foehnsturm/Mark2/Mark 2 expansion board/Expansion board schematic rev1.jpg

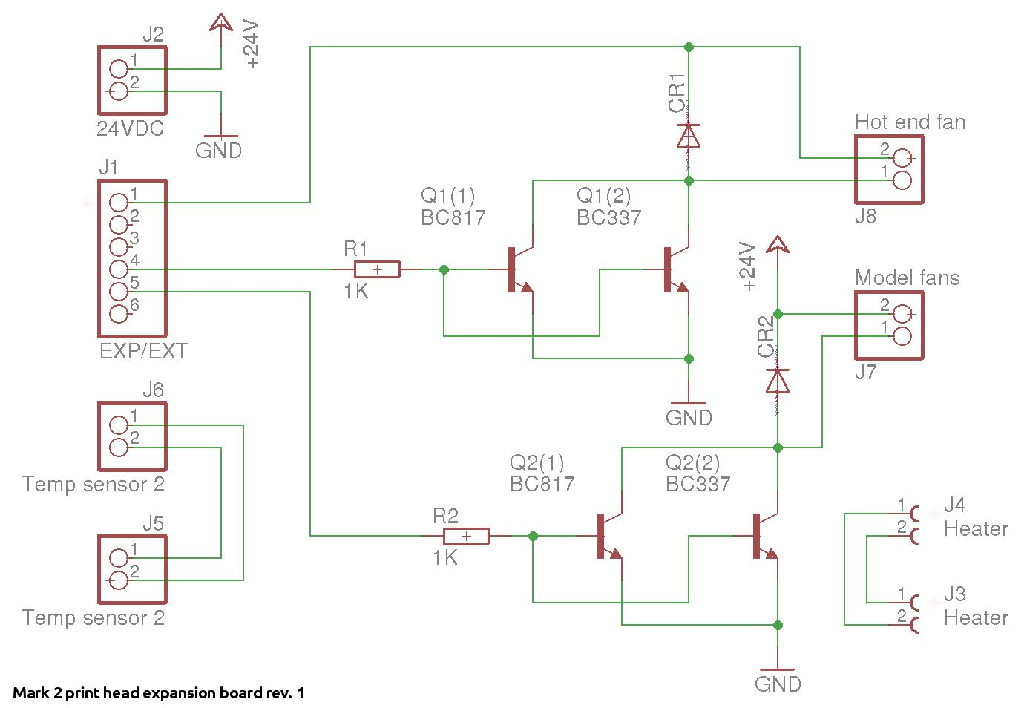
Mark 2 expansion board/Expansion board schematic rev1.jpg
