foehnsturm/Mark2/Mark 2 expansion board/Expansion board BOM rev1.xls

Mark 2 expansion PCB BOM
Designator | Type | Package | Description | RS components | Mouser | Farnell | Digi-key | Elfa | Legend
CR1 | S1G-E3/5AT | DO-214AC | Diode, 400V, 1A | 918-9663 | 625-S1G-E3/5AT | 9550240 | S1G-E3/5ATGICT-ND | 300-31-394 | SMD
CR2 | S1G-E3/5AT | DO-214AC | Diode, 400V, 1A | 918-9663 | 625-S1G-E3/5AT | 9550240 | S1G-E3/5ATGICT-ND | 300-31-394 | Through-hole
CR1 | 1N4004 | DO-41 | Diode, 400V, 1A | 738-4721 | 821-1N4004 | 9565027 | 1N4004DICT-ND | 110-52-625 | Common
CR2 | 1N4004 | DO-41 | Diode, 400V, 1A | 738-4721 | 821-1N4004 | 9565027 | 1N4004DICT-ND | 110-52-625
J1 |  |  | 0.1” 6-way dual row header, right angle | 767-0855 | 571-5-102975-3 | 2356195 | 5-102975-3-ND | 143-00-587
J2 |  |  | 0.1” breakaway header, right angle | 828-1651 | 538-22-28-8360 | 1593439 | WM50013-36-ND | 143-71-403
J3 |  |  | Terminal block, 5mm pitch | 361-7667 | 571-2828362 | 3089034 | A98076-ND | 300-42-827
J4 |  |  | Terminal block, 5mm pitch | 361-7667 | 571-2828362 | 3089034 | A98076-ND | 300-42-827
J5 | 171857-0002 |  | Molex KK-254, 2-way, right angle | 792-2893 | 538-171857-4002 | 2445505 | WM10157-ND | 300-65-089
J6 | 171857-0002 |  | Molex KK-254, 2-way, right angle | 792-2893 | 538-171857-4002 | 2445505 | WM10157-ND | 300-65-089
J7 | 171857-0002 |  | Molex KK-254, 2-way, right angle | 792-2893 | 538-171857-4002 | 2445505 | WM10157-ND | 300-65-089
J8 | S2B-XH-A |  | JST XH, 2-way, right angle | 820-1582 |  | 1516289 | 455-2257-ND | 143-02-006
Q1 | BC817-40 | SOT-23-3 | Transistor, 45V, 500mA | 464-243 | 863-BC817-40LT1G | 2317574 | 1727-2919-1-ND | 300-50-353
Q2 | BC817-40 | SOT-23-3 | Transistor, 45V, 500mA | 464-243 | 863-BC817-40LT1G | 2317574 | 1727-2919-1-ND | 300-50-353
Q1 | BC337-40 | TO-92 | Transistor, 45V, 500mA | 796-9672 | 610-BC337-40 | 9558675 | BC33740TACT-ND | 171-01-459
Q2 | BC337-40 | TO-92 | Transistor, 45V, 500mA | 796-9672 | 610-BC337-40 | 9558675 | BC33740TACT-ND | 171-01-459
R1 |  | 3216 (metric) | Resistor, 1K, 250mW | 808-4182 | 71-CRCW1206-1.0K-E3 | 1469965 | 541-1.00KFCT-ND | 300-56-913
R2 |  | 3216 (metric) | Resistor, 1K, 250mW | 808-4182 | 71-CRCW1206-1.0K-E3 | 1469965 | 541-1.00KFCT-ND | 300-56-913
R1 |  |  | Resistor, 1K, 250mW | 707-7666 | 660-MF1/4DCT52R1001F | 9341102 | CF14JT1K00CT-ND | 160-50-232
R2 |  |  | Resistor, 1K, 250mW | 707-7666 | 660-MF1/4DCT52R1001F | 9341102 | CF14JT1K00CT-ND | 160-50-232
Cable assemblies
Required | Type | Package | Description | RS components | Mouser | Farnell | Digi-key | Elfa
2 ea. | 22-01-2025 |  | Molex KK-254, 2-way crimp housing | 296-4934 | 538-22-01-2025 | 143126 | WM2613-ND | 143-80-465
2 ea. |  |  | 0.1" ribbon cable 6-way housing | 863-3251 | 649-71600-106LF | 2112419 | 609-2842-ND
2 ea. |  |  | 0.1" pitch, 2-way housing | 681-2812 | 855-M20-1060200 | 865606 | 952-2227-ND
4 ea. |  |  | 0.1” header crimp socket | 681-2878 | 855-M20-1160042 | 1022219 | 952-2158-ND
4 ea. | 08-50-0032 |  | Molex KK-254 crimp pin | 467-598 | 538-08-50-0032 | 2424111 | WM2623-ND | 143-80-598
60 cm |  |  | 28 AWG 1.27mm pitch ribbon cable | 815-8003 | 517-3365/06-100 | 2064464 | 3365/06 100-ND
2x30 cm |  |  | 18 AWG wire, PTFE / ETFE insulation
4x40 cm |  |  | 24 AWG wire, various colors
