foehnsturm/Mark2/calibration/mark2_xy_calibration_part_a.stl

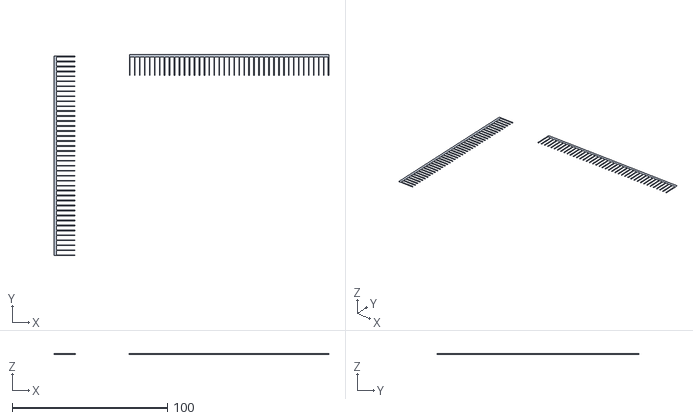
[picture p2: CAD file, 2017-04-28]
calibration/mark2_xy_calibration_part_a.stl
177.1 x 129.6 x 0.3
