foehnsturm/Mark2/part-files/coupling.stp

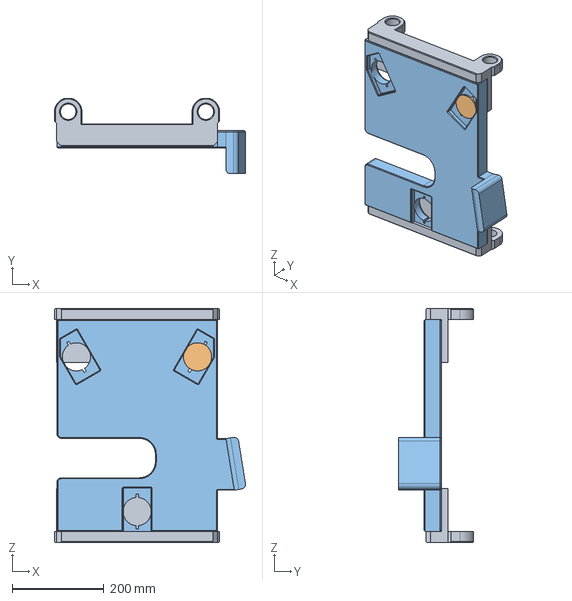
[picture p3: CAD file, 2018-01-26]
part-files/coupling.stp
416.6 x 164.2 x 510.0 mm
