foehnsturm/Mark2/calibration/mark2_xy_calibration_part_b.stl

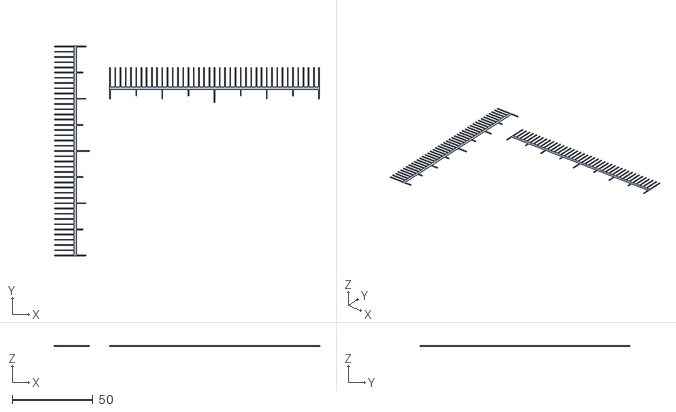
[picture p4: CAD file, 2017-04-28]
calibration/mark2_xy_calibration_part_b.stl
164.3 x 130.1 x 0.3
