foehnsturm/Mark2/part-files/head.stp

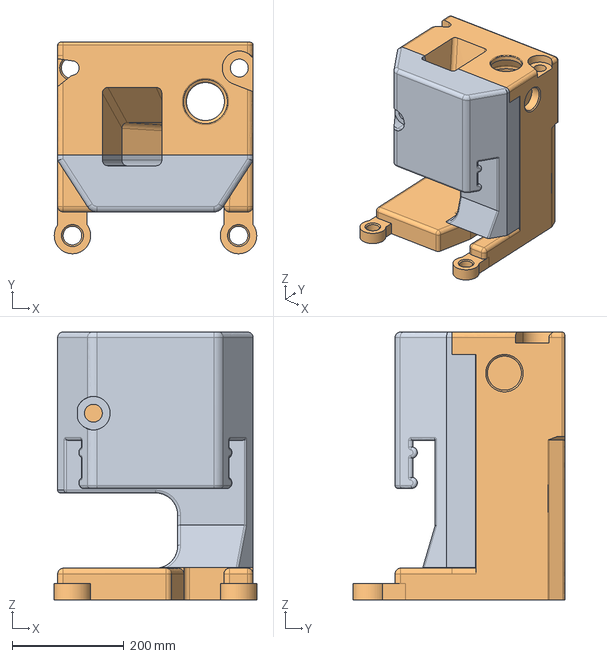
[picture p5: CAD file, 2018-01-26]
part-files/head.stp
362.8 x 378.9 x 480.0 mm
