foehnsturm/Mark2/part-files/head-b.stl

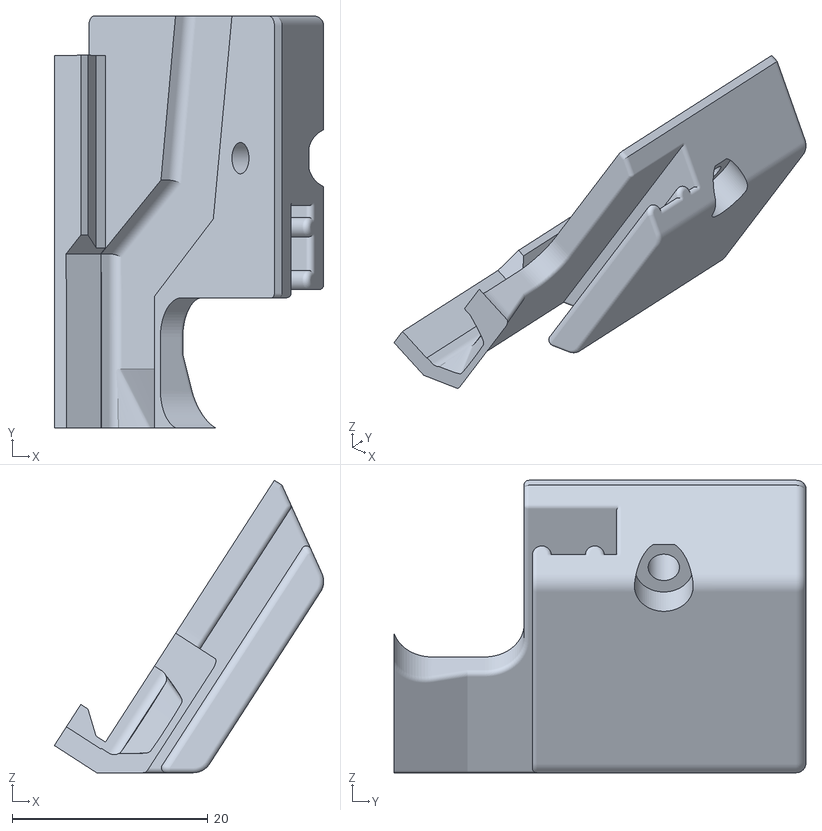
[picture p6: CAD file, 2018-01-26]
part-files/head-b.stl
27.6 x 42.1 x 29.9
