foehnsturm/Mark2/part-files/head-a.stl

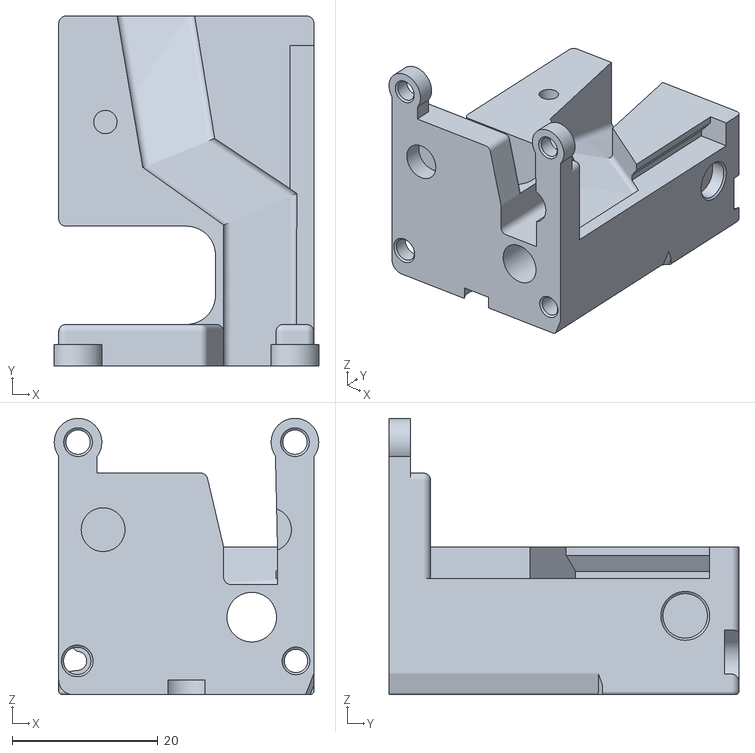
[picture p7: CAD file, 2018-01-26]
part-files/head-a.stl
36.3 x 48.0 x 37.9
