foehnsturm/Mark2/part-files/expansion-pcb-carrier.stl

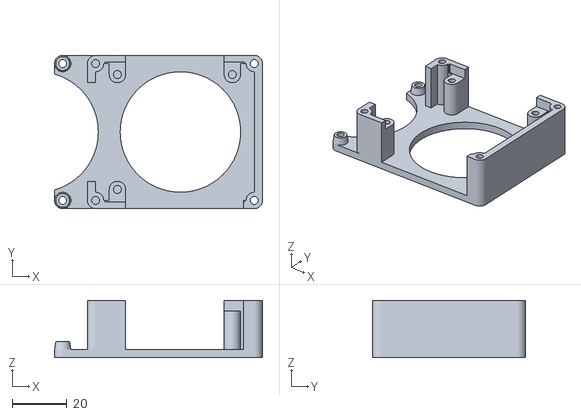
[picture p8: CAD file, 2017-05-04]
part-files/expansion-pcb-carrier.stl
76.0 x 56.0 x 21.0
