foehnsturm/Mark2/part-files/expansion-pcb-cable-clamp.stl

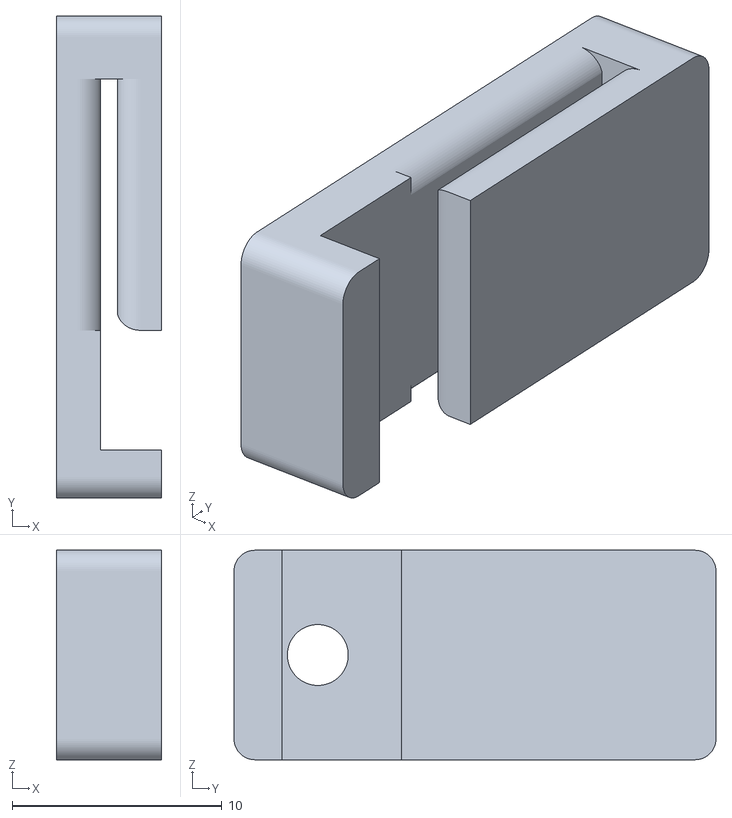
[picture p9: CAD file, 2017-05-04]
part-files/expansion-pcb-cable-clamp.stl
5.00 x 23.0 x 10.0
