foehnsturm/Mark2/part-files/expansion-pcb-cover.stl

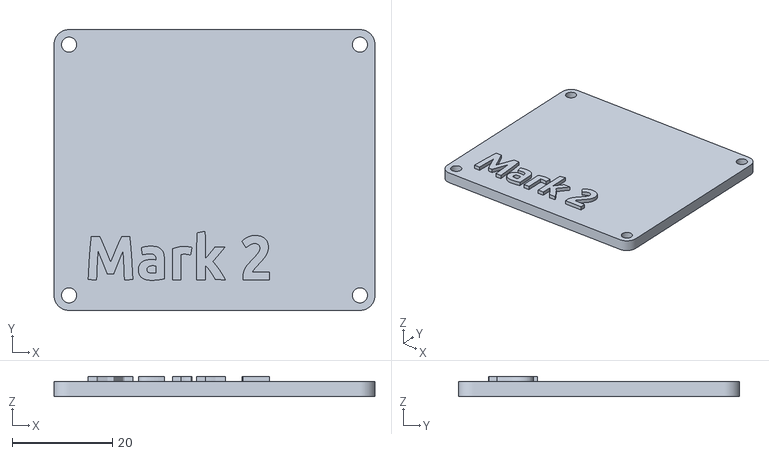
[picture p10: CAD file, 2017-05-04]
part-files/expansion-pcb-cover.stl
64.0 x 56.0 x 4.00
