foehnsturm/Mark2/part-files/cable-clamp.stp

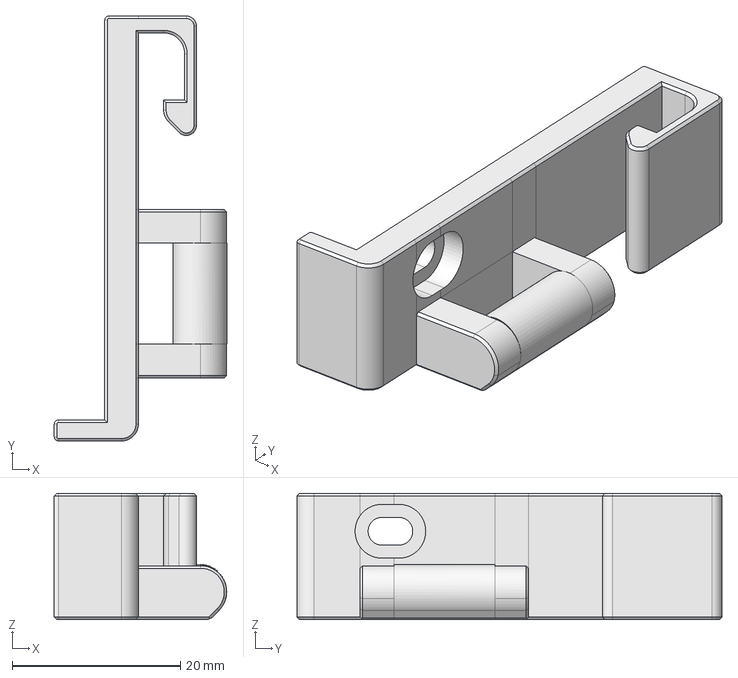
[picture p11: CAD file, 2017-04-28]
part-files/cable-clamp.stp
20.5 x 50.5 x 15.0 mm
