foehnsturm/Mark2/part-files/flex-wedge.stp

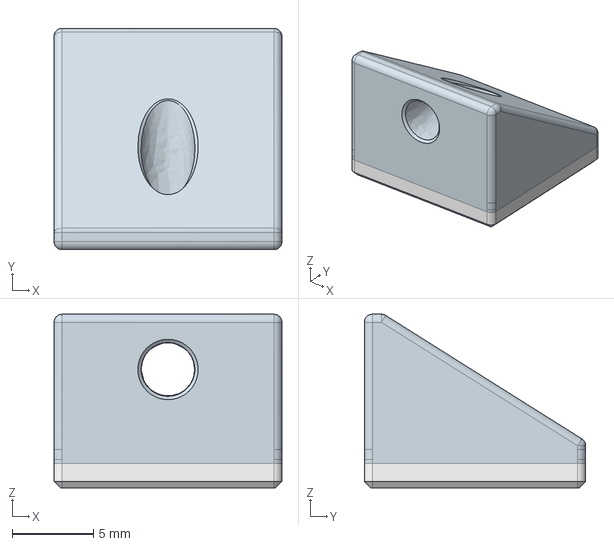
[picture p12: CAD file, 2017-04-28]
part-files/flex-wedge.stp
14.0 x 13.6 x 10.7 mm
