foehnsturm/Mark2/part-files/feeder-mount-roof.stp

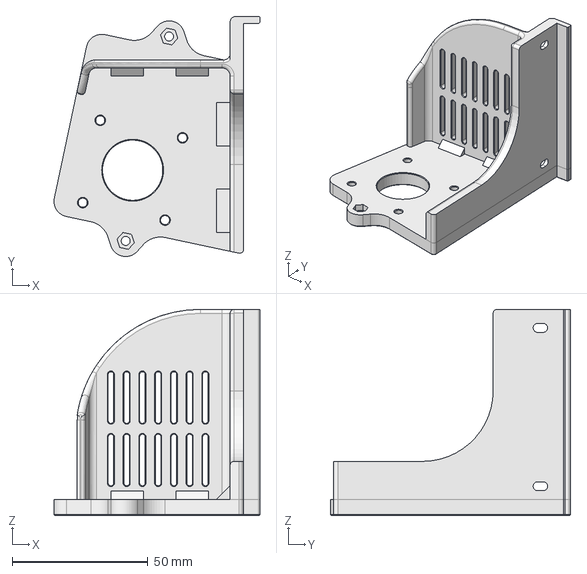
[picture p13: CAD file, 2017-04-28]
part-files/feeder-mount-roof.stp
75.9 x 88.4 x 76.0 mm
