foehnsturm/Mark2/part-files/adjustable-plate.stl

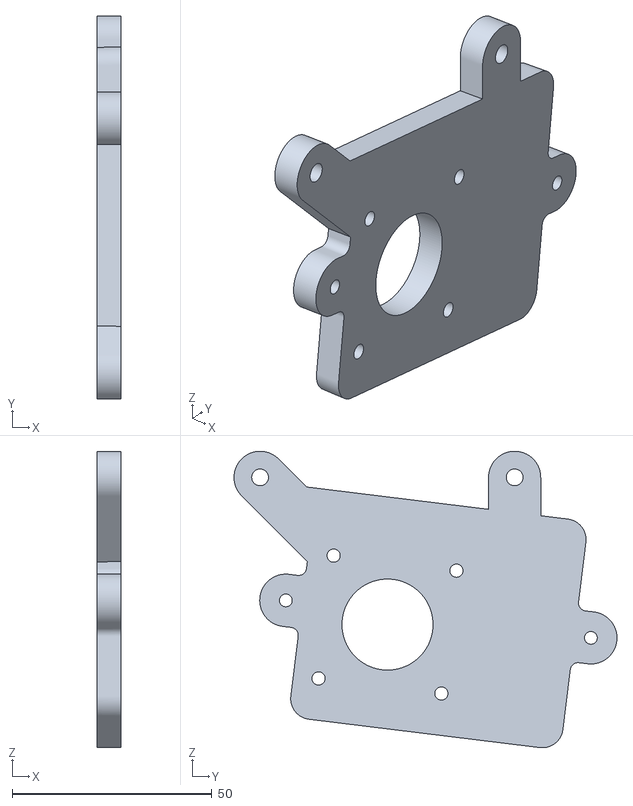
[picture p15: CAD file, 2017-04-28]
part-files/adjustable-plate.stl
6.00 x 96.0 x 74.3
