foehnsturm/Mark2/part-files/tesa-stick-dock-b.stl

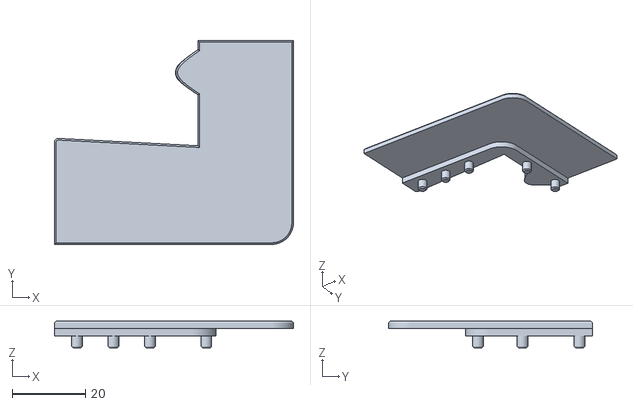
[picture p16: CAD file, 2017-04-28]
part-files/tesa-stick-dock-b.stl
65.5 x 55.8 x 7.30
