foehnsturm/Mark2/part-files/adjustable-feeder-mount.stp

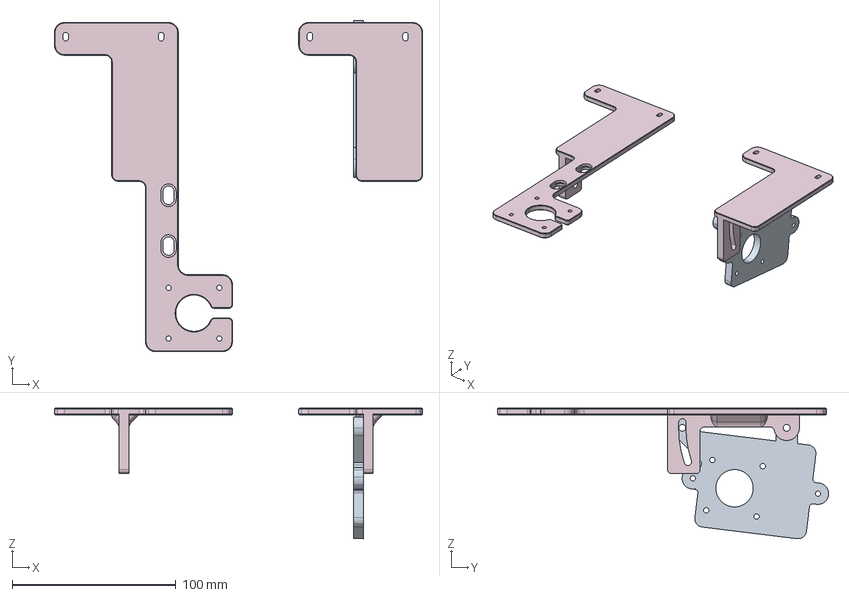
[picture p17: CAD file, 2017-04-28]
part-files/adjustable-feeder-mount.stp
224.8 x 202.3 x 79.7 mm
