foehnsturm/Mark2/part-files/adjustable-feeder-mount-with-motorhole.stl

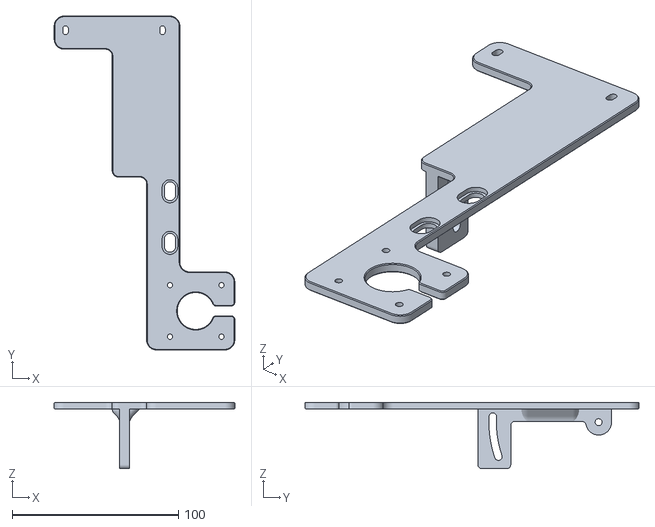
[picture p18: CAD file, 2017-04-28]
part-files/adjustable-feeder-mount-with-motorhole.stl
108.7 x 201.0 x 40.0
