foehnsturm/Mark2/part-files/tesa-stick-dock.stp

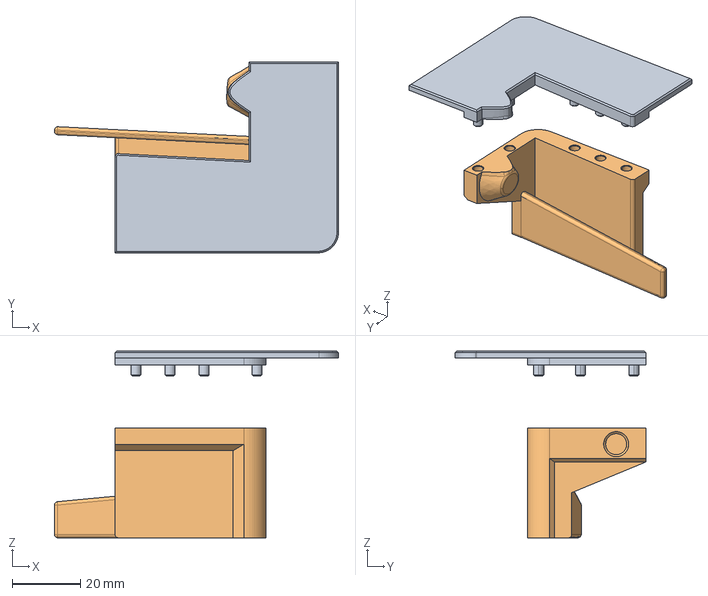
[picture p19: CAD file, 2017-04-28]
part-files/tesa-stick-dock.stp
83.2 x 55.8 x 54.7 mm
