foehnsturm/Mark2/part-files/tesa-stick-dock-a.stl

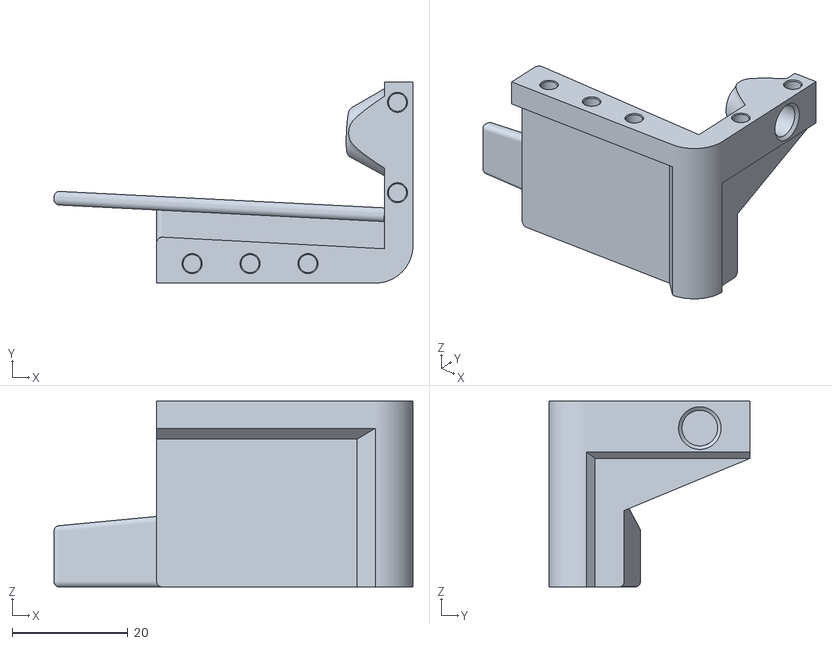
[picture p20: CAD file, 2017-04-28]
part-files/tesa-stick-dock-a.stl
62.0 x 34.7 x 32.1
