foehnsturm/Mark2/part-files/clamping-dock.stp

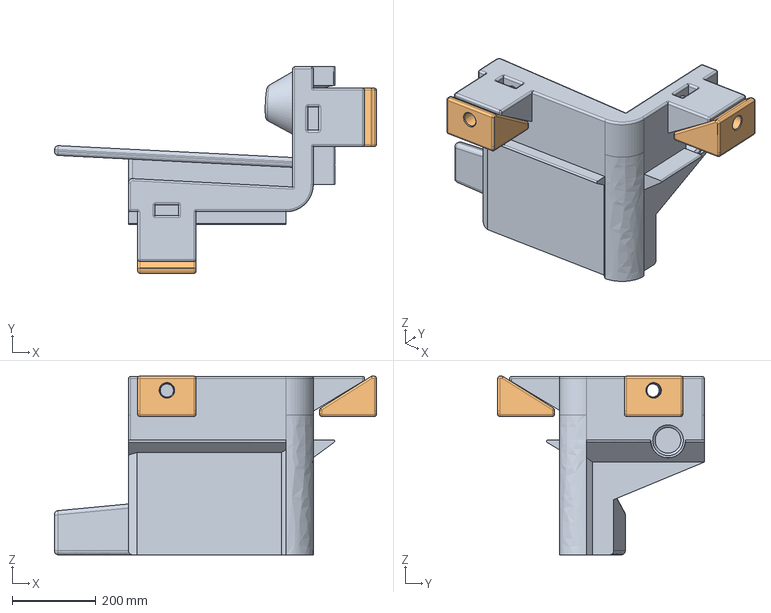
[picture p21: CAD file, 2017-03-07]
part-files/clamping-dock.stp
770.9 x 494.6 x 427.7 mm
