foehnsturm/Mark2/(list of files, cad)

Other CAD files:
part-files/adjustable-feeder-mount.stl
part-files/cable-clamp.stl
part-files/clamping-dock.stl
part-files/coupling.stl
part-files/feeder-mount-roof.stl
part-files/feeder-mount.stl
part-files/flex-wedge.stl
part-files/head.stl
