foehnsturm/Mark2/Mark 2 expansion board/Eagle files/Expansion board rev1.brd

## EAGLE design Mark 2 expansion board/Eagle files/Expansion board rev1.brd (2017-05-03)

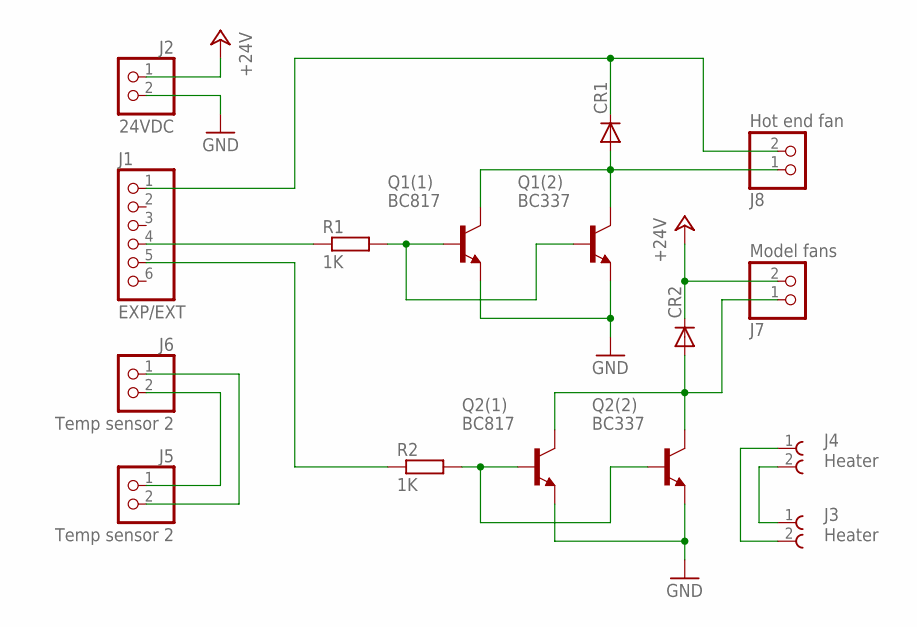
[picture p22: schematic Expansion board rev1.sch]

Parts:
CR1, CR2: TESTDIODE; DO214AC
J1: EXP/EXT; 2X03
J2: 24VDC; 1X02
J3, J4: Heater; 691216710002
J5, J6: Temp sensor 2; 1X02
J7: Model fans; 1X02
J8: Hot end fan; JST_XH_2_RA
Q1(1), Q2(1): BC817; SOT23-BEC
Q1(2), Q2(2): BC337; TO92
R1, R2: 1K; M3216

Connections:
+24V: CR2.C, J2.1, J7.2
GND: J2.2, Q1(1).E, Q1(2).1 (E), Q2(1).E, Q2(2).1 (E)
unnamed: CR2.A, J7.1, Q2(1).C, Q2(2).3 (C)
unnamed: J3.2, J4.1
unnamed: CR1.A, J8.1, Q1(1).C, Q1(2).3 (C)
unnamed: J3.1, J4.2
unnamed: Q2(1).B, Q2(2).2 (B), R2.2
unnamed: Q1(1).B, Q1(2).2 (B), R1.2
unnamed: CR1.C, J1.1, J8.2
unnamed: J1.5, R2.1
unnamed: J1.4, R1.1
unnamed: J5.1, J6.2
unnamed: J5.2, J6.1

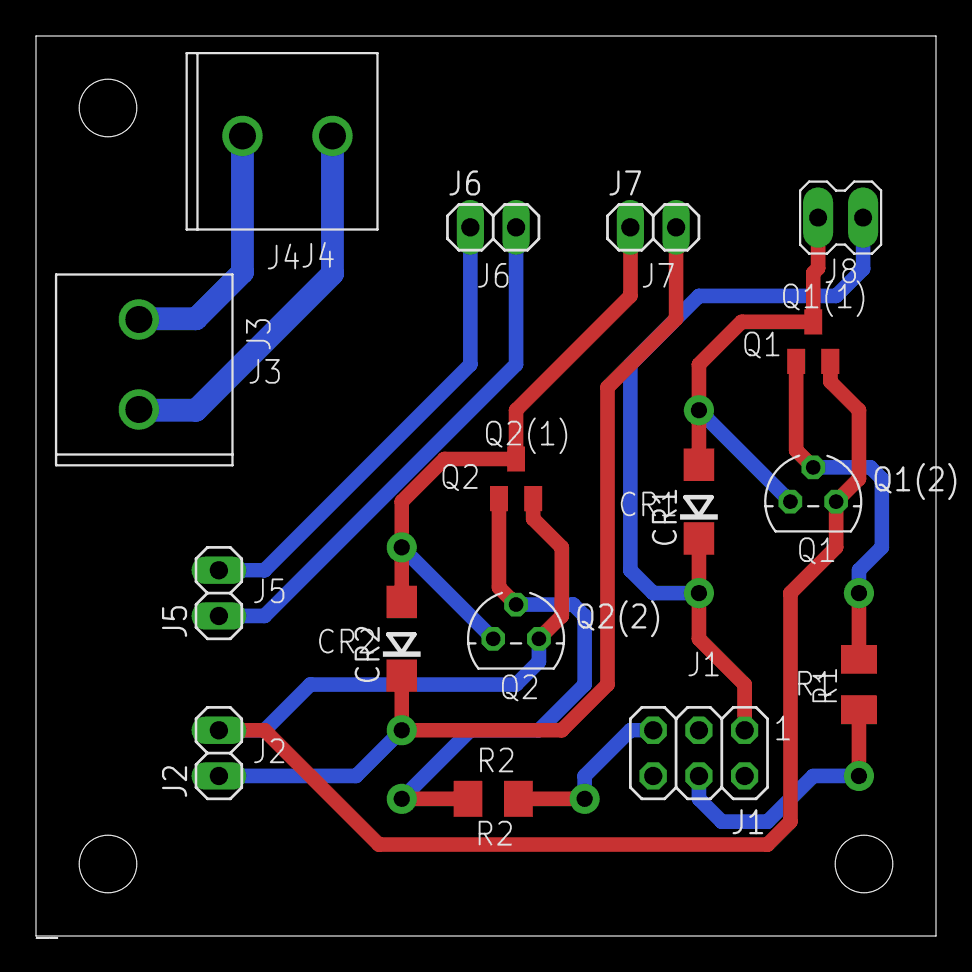
[picture p23: board Expansion board rev1.brd from above]

Board: 2 copper layers, 50.0 x 50.0 mm, 16 parts (0 on the bottom side), 13 nets.
