foehnsturm/Mark2/(threads)

Thread 1 (2017-03-07):

Head 1 x-axis crashes in head 2 at the beginning of a print

Melkaz, 2017-03-07:
At the beginning of a print, head 2 is primed then docked.
Then head 1 x-axis crashes into head 2 when moving for priming.

Do I need to change something in the start gcode ?

foehnsturm, 2017-03-07:
Check the wiping position in firmware for a safe y value > 23 mm

Melkaz, 2017-03-07:
I don't have any wiping

Melkaz, 2017-03-07:
Is the wiping position relevant even if I don't have a wiper ?

Did you mean the "priming" position ?

Melkaz, 2017-03-07:
In : `Advanced/Dual extrusion/Wipe position`
I set a y value of 23.5mm and it works flawlessly.

Closed 2017-03-07.

Thread 3 (2017-03-07):

Printer reboots while printing - Power budget issue

Melkaz, 2017-03-07:
I had problems with the Power Budget default settings (Total: 160W, Bed: 150W, Heater 1: 35W, Heater 2: 35W)

Melkaz, 2017-03-07:
I followed Foehnsturm advice and set : 130/170/40/40
Works well even though I get some flickering from the LED while heating.

Closed 2017-03-07.

Thread 17 (2017-10-23):

Mark2 Firmware files

bulior, 2017-10-23:
Hey Guys,

i really like your Mark2 Firmware on my costum Ultimaker2 ex. Next week i will get the parts for the second Hotend, so i´m really exited. Do you have the Um2 Extended Mark2 Firmware also uncompiled (not as .hex), because i really want to add some costum codes.

Sofar thanks and i will support you as soon as possible.

TinkerGnome, 2017-10-23:
Sure, the firmware source files can be found in [this branch](https://github.com/TinkerGnome/Ultimaker2Marlin/tree/Mark2). Take a look at the [build script](https://github.com/TinkerGnome/Ultimaker2Marlin/blob/Mark2/Marlin/package.sh) to see the used settings for UM2+ extended.

bulior, 2017-10-23:
Thanks for your fast answer. It is amazing what you have done within this firmware ! I have donated to your main side for inspiration ;)

foehnsturm, 2017-10-23:
Thanks a lot!

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

Föhnsturm GmbH
Centa-Herker-Bogen 52 : 80797 München
T 089 65119443 : F 089 65119741 : www.foehnsturm.de
HRB 119698 Amtsgericht München : Geschäftsführer Markus Seidt

Closed 2017-10-23.

Thread 20 (2018-06-06):

Firmware modification

Ultinfc, 2018-06-06:
Hi,  I really like your Mark2 concept and would love to make it. The only issue is that i need to make some more modifications in the firmware for my diy printer .. the heater pid settings and the extruder steps / rotation should be changed. At git i only see the .hex file. Guess you not want to share the source code..  but could you deliver me a special hex file then  as  possible solution?

TinkerGnome, 2018-06-09:
The source code is available too, but in a different repository (choose the branch "Mark2"):
[https://github.com/TinkerGnome/Ultimaker2Marlin/tree/Mark2](https://github.com/TinkerGnome/Ultimaker2Marlin/tree/Mark2)
