foehnsturm/Mark2/(commit log)

2017-03-26 Added modified dock wedge for use with flexible filament.
    This should improve grip and reduce the risk of over tightening.
    [flex-wedge-rc1.step, flex-wedge-rc1.stl]
2017-04-14 add part-files for feeder-mount
    [feeder-mount-rc1.step, feeder-mount-rc1.stl, feeder-mount-roof-rc1.step, feeder-mount-roof-rc1.stl]
2017-04-17 add part-files for the (optional) cable-clamp
    [cable-clamp-rc1.step, cable-clamp-rc1.stl]
2017-04-18 Coupling with slightly changed pockets for the magnets. Split head stl in two files because only one needs support
    [coupling-rc2.stl, coupling-rc2.stp, head-rail-a-rc1.stl, head-rail-b-rc1.stl]
2017-04-18 removed coupling rc1 files
    [coupling-a-rc1.stl, coupling-a-rc1.stp]
2017-04-25 add files for xy-calibration
    [mark2_xy_calibration_part_a.stl, mark2_xy_calibration_part_b.stl]
2017-04-28 added tese stick dock and adjustable feeder mount
    [Mark2AdjustableFeederMount.stp, Mark2AdjustableFeederMountForUM2.stl, Mark2AdjustableFeederMountForUM2withMotorhole.stl, Mark2AdjustablePlate.stl, RC1-TesaStickRail.stp, RC1-UltiArjanRailA.stl, RC1-UltiArjanRailB.stl]
2017-05-02 added BOM
2017-05-02 changed length of print hread screws
2017-05-02 renamed BOM
2017-05-03 renaming for consistent file names
    [adjustable-feeder-mount-with-motorhole.stl, adjustable-feeder-mount.stl, adjustable-feeder-mount.stp, adjustable-plate.stl, cable-clamp.stl, cable-clamp.stp, clamping-dock.stl, clamping-dock.stp]
2017-05-03 BOM change
    Because it's likely nobody wants a reel of 150+ diodes
    [Expansion board BOM rev1.xls]
2017-05-04 Add files via upload
    Added expansion board carrier + clamps
    [expansion-pcb-cable-clamp.stl, expansion-pcb-carrier.stl, expansion-pcb-cover.stl]
2017-07-14 firmware update V17.06: round extruder offsets to a multiple of a step
2017-08-21 bugfix: add "G92 E0" at the end of the start script (CuraEngine always assumes E coord == 0 at the beginning of a print)
2018-01-26 Corrected hole depth for the magnets
    Holes in the print head now 2 mm deep instead of 2.4 mm. Coupling plate now 3.75 mm instead of 3.95 mm. Now there should be a gap of 0.25 mm between both parts when the magnets are inserted.
    [coupling.stl, coupling.stp, head-a.stl, head-b.stl, head.stl, head.stp]
2018-02-07 Eliminated 0.25 mm z offset of both parts
    [head.stl]
2019-03-10 firmware V19.03.1 - fix a bug in power budget when build plate is in bang-bang mode - add material load function to the MOVE menu
