foehnsturm/Mark2/(notices)

Notices in the files:
parts and their libraries:
Wurth_EAGLE-TERMINAL_BLOCKS-rev16e: Copyright: Würth Elektronik
